joulupukki/esp32-chromatic-tuner/assembly/Schematic.png

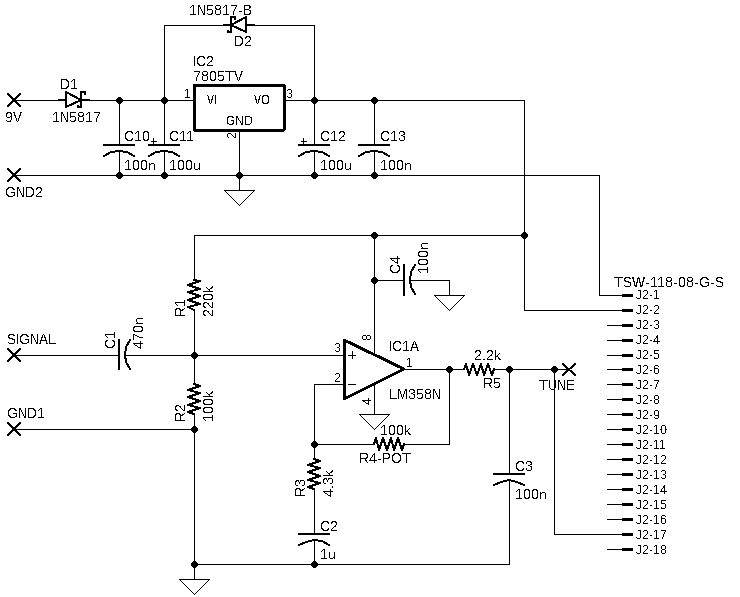
assembly/Schematic.png
