joulupukki/esp32-chromatic-tuner/assembly/Components.pdf

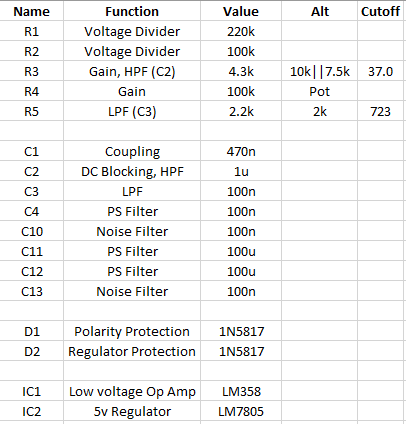
[picture p2: page 1]
