joulupukki/esp32-chromatic-tuner/(threads)

Thread 4 (2024-08-26):

Add support for a mode button/switch

joulupukki, 2024-08-26:
The tuner should be able to support multiple "modes" of tuning. This is mostly for the UI.

Two ways to implement this from a hardware perspective:
1. Use a three-way switch that's hooked up to three different GPIO pins. Depending on the switches orientation the software could (at startup) use the specified mode.
2. Use a momentary button that would cycle through the different available modes. To prevent accidental press, this could be implemented as a long press mechanism

Some modes that could be nice:
1. Normal tuning mode (what we already have)
2. Raw mode: gives just basic frequency, note, and cents reading
3. Debug mode: continuously spits out info about voltage reading, intermediate values (after applying filters etc), frequency, cents, etc.
4. Additional UI modes in the future (like simulated strobe mode or just different UI layouts)

The code needs to be changed so that it can read the value of the switch at startup and/or during each loop. Also, to keep memory consumption low, UI elements for each mode (and processing) should be torn down as needed.

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
joulupukki, 2024-12-07:
Closing this one because we're going to implement it in a different way.

Closed 2024-12-07.

Thread 11 (2024-12-07):

Add a smoothing function on the detected frequency so the UI doesn't jump around as much

joulupukki, 2024-12-07:
The ADC sampling happens at 48kHz and as soon as we detect a frequency, we're making it available to the UI. The UI updates every 100ms. The smoothing we currently have isn't sufficient and it might be nice to have an additional smoothing on the frequency output so by the time it reaches the UI, the jumps aren't as drastic or as much.

The key here is to see if we can make it so you can really tune within 0.02 cents and visually see that in the UI.

One of the things we may be up against is that the ESP32 ADC isn't the best compared with other SOCs out there. But, this is all part of the "fun" challenge of using a readily-available and inexpensive SOC.

joulupukki, 2024-12-08:
I did a little bit of work on this Saturday, Dec 7. The latest in `main` as of right now is fairly decent, though I think it can be still improved.

joulupukki, 2025-02-10:
> There’s an algorithm, not sure what it’s called, where you sample an odd number of readings, order the readings, and only use the reading in the middle of the readings. I’d like to try that on the output of the frequency readings to see if that helps smooth things a bit more.

It's called a Median Filter and I've been experimenting with it. I think it slightly improves how Q-Tune works.

Thread 9 (2024-12-07):

Try out using lv_menu instead of buttons for the settings menu

joulupukki, 2024-12-07:

joulupukki, 2024-12-07:
So far this is not going great. Even after increasing the stack size available to LVGL and using the most basic example from the LVGL documentation it still crashes regularly with an overflow error.

joulupukki, 2024-12-10:
Need to revisit this now that we have the device running at 240MHz to see if this still causes issues. Running at this faster speed has prevented the previous crashes with the note name label we were seeing.

Closed 2025-02-08.

Thread 15 (2024-12-08):

Add synchronization around the current_frequency variable (shared between both cores)

joulupukki, 2024-12-08:
The `current_frequency` global variable is the main means of communication between the two cores and it’s possible that some of the crashes that we’re experiencing could be caused by this.

Some ideas to try: https://chatgpt.com/share/67554351-7c18-8010-bc82-93a870aeeb30

Another thing to look into is the LVGL setting for sprintf. Right now, in order to make the frequency and cents measurements show up in the UI we’ve got an sdkconfig setting that doesn’t use the built-in LVGL string formatting. We may also want to look at using LVGL’s sprintf and see if *that* also reduces the number of crashes that currently happen.

joulupukki, 2024-12-08:
Maybe what needs to happen is to create a new “globals.h” file that has all of the app-wide global variables in it and also the functions that synchronize them? The other variable that needs to be there is the one that indicates that either tuning is paused or that the user settings are showing (so the pitch detection doesn’t have to run during that time). Maybe the overall “mode” of the tuner (bypass/standby/tuning/etc).

joulupukki, 2024-12-08:
Implemented 8 Dec 2024.

Closed 2024-12-08.

Thread 16 (2024-12-08):

Add support for the momentary foot switch and bypass relay control

joulupukki, 2024-12-08:
I will add more details to this later but, the app needs to read when the footswitch closes and, based on user settings, send a signal out to the latching relay to open/close. It will also need to tell the UI to pause/go into standby mode/etc.

TODO: Document what GPIO will be used for the footswitch input and the relay output.

I’m thinking that right now the footswitch reading and relay control will happen on Core 0 (where we’re doing all of the LVGL stuff) and not on Core 1 (where we’re doing ADC reading of the analog input signal).

Thread 17 (2024-12-08):

Add new menu setting inside “Tuner” that sets the bypass/standby mode

joulupukki, 2024-12-08:
Inside the Tuner/Tuning menu, we need a “Bypass Mode” or “Standby Mode” options where you can choose:

1. Mute during tuning
2. Monitor during tuning (tuning is still active)

If “Mute while tuning” is selected, we need to also figure out what to show on the screen:
1. Blank
2. Some sort of screensaver
3. Picture
4. Words? Set list? Etc.?

Thread 25 (2024-12-10):

See if it's possible to switch the main note display from text to an image

joulupukki, 2024-12-10:
For whatever reason, I'm still seeing glitches with displaying the note. It will have garbled stuff occasionally. Can an image be used instead? Can images be template images that get colorized?

joulupukki, 2024-12-10:
Still need to try image recoloring for maybe even a better experience. I still see an occasional '?' show up where the note name label should be – even for a fraction of a second.

joulupukki, 2024-12-10:
I've loaded in the [Fira Mono](https://fonts.google.com/specimen/Fira+Mono?preview.text=A%20B%20C%20D%20E%20F%20G%20%23%20%E2%80%93) font by creating PNG images of each note and then using LVGL's online image creator. Need to still do some testing.

I also bumped the memory cache size to 327680.

joulupukki, 2024-12-11:
This is now implemented with this pull request: https://github.com/joulupukki/esp32-chromatic-tuner/pull/28

Closed 2024-12-11.

Thread 31 (2024-12-11):

Touches on the CYD screen can be off – need to add a touch screen calibration option

joulupukki, 2024-12-11:
The touches on my CYD are slightly off. That means that it’s possible others will experience that too. I think that means we need to add a calibration option to the Display user settings menu.

In a quick search I discovered this project. It may have something that’d help: https://github.com/jakpaul/lvgl_touch_calibration

joulupukki, 2024-12-11:
When the software first loads, it should check to see if calibration info has been stored in Non-Volatile Storage (NVS). If it hasn’t, it should open the settings screen to calibrate it right away. Of course, give the user an option to skip it if they really want.

joulupukki, 2025-02-05:
While researching code to prevent noise I came across something (should have written it down) that this isn't actually needed with CYD. Keep an eye on it and this is something we may do in the future, but not for now.

joulupukki, 2025-02-11:
If this needs to happen in the future, this might be useful to reference: https://github.com/xperiments-in/xtouch/blob/main/src/devices/2.8/touch.h

Closed 2025-02-05.

Thread 33 (2024-12-11):

Figure out how to create a downloadable tool or method for installing firmware updates

joulupukki, 2024-12-11:
Eventually a person (non-technical) should be able to download firmware updates and install it onto the tuner without needing to install extra software like Visual Studio Code/etc. This GitHub Issue is a placeholder for doing the investigatory work and building such a tool and recommending a good release process.

joulupukki, 2025-02-08:
I did a little bit of research yesterday about this and I think what we’ll want to do is an over-the-air (OTA) update. To update the firmware you would:

1. Go into Q-Tune’s user settings
2. Go into the About menu
3. Select a Firmware Update option
4. Confirm the selection
5. The Q-Tune would reboot and would turn on Wi-Fi and broadcast a new Wi-Fi network, `q-tune-xyz` as an example with a password. Ideally, we’d figure out a way to show the network name and password on the screen.
6. You’d download the firmware update file, `q-tune-x.y.z.bin`
7. You’d then connect to the `q-tune-xyz` Wi-Fi network
8. You’d then launch a browser on your computer and go to the `q-tune.local` URL
9. You’d upload the `q-tune-x.y.z.bin` file
10. You’d click the Update button on the web page
11. Q-Tune would then install that `.bin` file and reboot into normal tuning mode with the update

joulupukki, 2025-02-10:
Turns out that the firmware for Q-Tune is too large to enable the Wi-Fi library in conjunction with it and LVGL so doing what I thought of earlier isn't going to work.

However, if we do a web-based updater, it should work. For example, just like this site: https://esphome.github.io/esp-web-tools/

joulupukki, 2025-03-25:
I have an update-installer.sh script that updates the installer but what we really need is something to support installing older versions.

Thread 48 (2025-02-05):

5kHz noise in the audio

joulupukki, 2025-02-05:
The LCD backlight code is using PWM at 5kHz and it can be heard in the audio output.

Closed 2025-02-05.

Thread 50 (2025-02-05):

Control user settings with foot switch

joulupukki, 2025-02-05:
We are planning to use a cover glass/lens to do a few different things:

1. Protect the CYD screen
2. Make a more professional looking screen in the finished product
3. Make the pedal a bit more weather/drink resistant (at least from the top)

Because of this, we will no longer be using the touch panel feature and instead need to control all of user settings from a single footswitch button.

Things that need to be done:

- [ ] Don't even initialize the touch panel (for this one we would wait and see as this may be dependent on the cover glass mounting).
- [x] Experiment with either using a long press to open user settings _or_ only going into user settings when powering on the tuner and the footswitch is depressed. Choose whichever one seems most reliable and go with it. It may be that we want to use long press later on for controlling a timer, so maybe prefer the startup hold?
- [x] Modify the menu system so there is a cursor/indicator on what is currently selected (a selection mechanism)
- [x] Use the footswitch to navigate the menu. Single press advances to the next item in the list. Double-press activates the currently-selected item. Long-press exits the menu if at the top level or going back one level in the menu hierarchy.
- [ ] Change some of the menu items to be more conducive to this new navigation. First see if it’s possible to navigate the different items (display brightness slider, tuner threshold rolling picker, advanced debugging items). If it’s not apparent right away, change those menus to use standard buttons and/or radio buttons.

Closed 2025-02-07.

Thread 52 (2025-02-07):

Before release, disable touch panel initialization

joulupukki, 2025-02-07:
We're using the foot switch to control navigation of user settings and the touch panel will no longer be used. It may be helpful in development mode, but the LCD will be covered by a cover lens.

joulupukki, 2025-03-16:
Touch is currently commented out and not being added.

joulupukki, 2025-04-21:
Closing this because we now have a new feature request to add capacitive touch with the new Waveshare ESP32 2.8" Touch.

Closed 2025-04-21.

Thread 53 (2025-02-07):

Remove the settings gear icon/button from the tuning screen before release

joulupukki, 2025-02-07:
We'll ship without the touch panel being used so there's no reason to have the settings button. Settings can be accessed with a long press of the foot switch.

joulupukki, 2025-03-25:
This is commented out now. If we restore touch capabilities we can always re-enable it.

Closed 2025-03-25.

Thread 64 (2025-03-16):

Attempt to use RMT instead of ADC Continuous reading for frequency detection

joulupukki, 2025-03-16:
It might be possible to use RMT instead of ADC measurements since the pitch detection algorithm we're using is just counting zero crossings. This is an issue to track that work.

RMT API Reference: https://docs.espressif.com/projects/esp-idf/en/v5.3.2/esp32/api-reference/peripherals/rmt.html

joulupukki, 2025-03-23:
Shelving this for now. Existing ADC is working well enough I don't think this is needed.

Closed 2025-03-23.

Thread 65 (2025-03-16):

Enhancement: Add support for the capacitive touch screen

joulupukki, 2025-03-16:
The project recently switched to use the Waveshare ESP32-S3 Touch 2.8" (240x320) and it has a capacitive touch panel. I've done some of the work at porting it over but something isn't quite right. The tuner can be controlled from the single foot switch momentary button but it might be interesting to get the touch controller fully working for easier setup menu navigation.

When I had it partially working with esp_lvgl_port it would act like it might accept a touch but would then crash.

Thread 66 (2025-03-23):

Add support for setting True Bypass & Buffered Bypass with a 2nd relay switch

joulupukki, 2025-03-23:
Use GPIO_NUM_15 for controlling a second TQ2-L2-5V relay. Add this as a user setting. When in buffered bypass mode, GPIO_NUM_15 should be set to ON which will send 3.3V. When power is cut to the pedal, it should automatically reset to the default mode (true bypass) – which isn't really a supported "feature" but it happens to work out well that way.

Thread 79 (2025-04-29):

Prep Note Quiz for release

joulupukki, 2025-04-29:
- [ ] Change the included tuner so it uses something similar to how Rocksmith’s small tuner works with a circle around the note and cents on left and right
- [ ] Show “Play now” and “Up next” on the notes
- [ ] Adapt so it functions well in landscape mode
- [ ] Revisit the colors
- [ ] See if there’s a way to give some sort of cool feedback when the target note is played. Maybe animate the new note into place?
