joulupukki/esp32-chromatic-tuner/main/defines.h

/*
 * Copyright (c) 2024 Boyd Timothy. All rights reserved.
 *
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
 * SPDX-License-Identifier: GPL-3.0-or-later
 */
#if !defined(TUNER_GLOBAL_DEFINES)
#define TUNER_GLOBAL_DEFINES

//
// Foot Switch and Relay (GPIO)
//
#define FOOT_SWITCH_GPIO                GPIO_NUM_27
#define RELAY_GPIO                      GPIO_NUM_22

#define LONG_PRESS_THRESHOLD            2000 // milliseconds
#define DOUBLE_CLICK_THRESHOLD          500 // milliseconds

//
// Default User Settings
//
#define DEFAULT_INITIAL_STATE           ((TunerState) tunerStateTuning)
#define DEFAULT_STANDBY_GUI_INDEX       (0)
#define DEFAULT_TUNER_GUI_INDEX         (0)
#define DEFAULT_IN_TUNE_CENTS_WIDTH     ((uint8_t) 2)
#define DEFAULT_NOTE_NAME_PALETTE       ((lv_palette_t) LV_PALETTE_NONE)
#define DEFAULT_DISPLAY_ORIENTATION     ((TunerOrientation) orientationNormal);
#define DEFAULT_EXP_SMOOTHING           ((float) 0.09)
#define DEFAULT_ONE_EU_BETA             ((float) 0.003)
#define DEFAULT_NOTE_DEBOUNCE_INTERVAL  ((float) 115.0)
#define DEFAULT_USE_1EU_FILTER_FIRST    (true)
// #define DEFAULT_MOVING_AVG_WINDOW       ((float) 100)
#define DEFAULT_DISPLAY_BRIGHTNESS      ((float) 0.75)

//
// Pitch Detector Related
//
#define TUNER_ADC_UNIT                    ADC_UNIT_1
#define _TUNER_ADC_UNIT_STR(unit)         #unit
#define TUNER_ADC_UNIT_STR(unit)          _TUNER_ADC_UNIT_STR(unit)
#define TUNER_ADC_CONV_MODE               ADC_CONV_SINGLE_UNIT_1
#define TUNER_ADC_ATTEN                   ADC_ATTEN_DB_12
#define TUNER_ADC_BIT_WIDTH               12

// #if CONFIG_IDF_TARGET_ESP32 || CONFIG_IDF_TARGET_ESP32S2
#define TUNER_ADC_OUTPUT_TYPE             ADC_DIGI_OUTPUT_FORMAT_TYPE1
#define TUNER_ADC_GET_CHANNEL(p_data)     ((p_data)->type1.channel)
#define TUNER_ADC_GET_DATA(p_data)        ((p_data)->type1.data)
// #else
// #define TUNER_ADC_OUTPUT_TYPE             ADC_DIGI_OUTPUT_FORMAT_TYPE2
// #define TUNER_ADC_GET_CHANNEL(p_data)     ((p_data)->type2.channel)
// #define TUNER_ADC_GET_DATA(p_data)        ((p_data)->type2.data)
// #endif

// CYD @ 48kHz
#define TUNER_ADC_FRAME_SIZE            1024
#define TUNER_ADC_BUFFER_POOL_SIZE      4096
#define TUNER_ADC_SAMPLE_RATE           (48 * 1000) // 48kHz

/// @brief This factor is used to correct the incoming frequency readings on ESP32-WROOM-32 (which CYD is). This same weird behavior does not happen on ESP32-S2 or ESP32-S3.
#define WEIRD_ESP32_WROOM_32_FREQ_FIX_FACTOR    1.2222222223 // 11/9 but using 11/9 gives completely incorrect results. Weird.

// HELTEC @ 20kHz
// #define TUNER_ADC_FRAME_SIZE            (SOC_ADC_DIGI_DATA_BYTES_PER_CONV * 256)
// #define TUNER_ADC_BUFFER_POOL_SIZE      (TUNER_ADC_FRAME_SIZE * 16)
// #define TUNER_ADC_SAMPLE_RATE           (20 * 1000) // 20kHz

// Original HELTEC
// #define TUNER_ADC_FRAME_SIZE            (SOC_ADC_DIGI_DATA_BYTES_PER_CONV * 64)
// #define TUNER_ADC_BUFFER_POOL_SIZE      (TUNER_ADC_FRAME_SIZE * 4)
// #define TUNER_ADC_SAMPLE_RATE           (5 * 1000) // 5kHz

// If the difference between the minimum and maximum input values
// is less than this value, discard the reading and do not evaluate
// the frequency. This should help cut down on the noise from the
// OLED and only attempt to read frequency information when an
// actual input signal is being read.
// #define TUNER_READING_DIFF_MINIMUM      400 // TODO: Convert this into a debug setting
#define TUNER_READING_DIFF_MINIMUM      300 // TODO: Convert this into a debug setting

//
// Smoothing
//

// 1EU Filter
#define EU_FILTER_ESTIMATED_FREQ        48000 // Same as https://github.com/bkshepherd/DaisySeedProjects/blob/main/Software/GuitarPedal/Util/frequency_detector_q.h
#define EU_FILTER_MIN_CUTOFF            0.5
#define EU_FILTER_DERIVATIVE_CUTOFF     1

//
// GUI Related
//

#define A4_FREQ                         440.0
#define CENTS_PER_SEMITONE              100

#define INDICATOR_SEGMENTS              100 // num of visual segments for showing tuning accuracy

#define GEAR_SYMBOL "\xEF\x80\x93"

//
// When the pitch stops being detected, the note can fade out. This is how long
// that animation is set to run for.
#define LAST_NOTE_FADE_INTERVAL_MS  2000

#endif
