joulupukki/esp32-chromatic-tuner/main/gpio_task.cpp

/*
 * Copyright (c) 2024 Boyd Timothy. All rights reserved.
 *
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
 * SPDX-License-Identifier: GPL-3.0-or-later
 */
#include "gpio_task.h"

#include "defines.h"
#include "globals.h"
#include "tuner_controller.h"
#include "user_settings.h"

#include "lvgl.h"
#include "esp_lvgl_port.h"
#include "esp_log.h"
#include "freertos/FreeRTOS.h"
#include "esp_timer.h"

static const char *TAG = "GPIO";

extern TunerController *tunerController;
extern UserSettings *userSettings;

// Keep track of what the relay state is so the app doesn't have to keep making
// calls to set it over and over (which chews up CPU).
uint32_t current_relay_gpio_level = 0; // Off at launch

int footswitch_last_state = 1; // Assume initial state is open (active-high logic and conveniently matches the physical position of the footswitch)
int footswitch_press_count = 0;
int64_t footswitch_start_time = 0;
int64_t footswitch_last_press_time = 0;
bool footswitch_long_press_triggered = false;

//
// Local Function Declarations
//
void configure_gpio_pins();
void handle_gpio_pins();
void ensure_relay_state();
void handle_normal_press();
void handle_double_press();
void handle_long_press();

void gpio_task(void *pvParameter) {
    ESP_LOGI(TAG, "GPIO task started");
    configure_gpio_pins();

    while(1) {
        handle_gpio_pins();
        ensure_relay_state();

        vTaskDelay(pdMS_TO_TICKS(50)); // Small delay for debouncing
    }
    vTaskDelay(portMAX_DELAY);
}

void configure_gpio_pins() {
    // Configure GPIO 27 as an input pin
    gpio_config_t gpio_27_conf = {
        .pin_bit_mask = (1ULL << FOOT_SWITCH_GPIO),
        .mode = GPIO_MODE_INPUT,
        .pull_up_en = GPIO_PULLUP_ENABLE,   // Enable internal pull-up resistor
        .pull_down_en = GPIO_PULLDOWN_DISABLE,
        .intr_type = GPIO_INTR_DISABLE      // Disable interrupt for this pin
    };

    gpio_config(&gpio_27_conf);

    // Configure GPIO 22 as an output pin
    gpio_config_t gpio_22_conf = {
        .pin_bit_mask = (1ULL << RELAY_GPIO),
        .mode = GPIO_MODE_OUTPUT,
        .pull_up_en = GPIO_PULLUP_DISABLE,
        .pull_down_en = GPIO_PULLDOWN_DISABLE,
        .intr_type = GPIO_INTR_DISABLE
    };

    gpio_config(&gpio_22_conf);

    // TODO: Read the initial state of the foot switch. If it's a 0, that means
    // the user had it pressed at power up and we may want to do something
    // special.

    // Make sure the relay start out as off
    gpio_set_level(RELAY_GPIO, 0); // Turn off GPIO 22
    current_relay_gpio_level = 0;
}

void handle_gpio_pins() {

    // Detect press, double-press, and long press.

    int current_footswitch_state = gpio_get_level(FOOT_SWITCH_GPIO);

    if (current_footswitch_state == 0 && footswitch_last_state == 1) {
        // Button pressed
        footswitch_start_time = esp_timer_get_time() / 1000; // Get time in ms
        int64_t now = footswitch_start_time;

        if ((now - footswitch_last_press_time) <= DOUBLE_CLICK_THRESHOLD) {
            footswitch_press_count++;
        } else {
            footswitch_press_count = 1;
        }

        footswitch_last_press_time = now;
        footswitch_long_press_triggered = false; // Reset long press trigger when pressed
    }

    if (current_footswitch_state == 0) {
        // Button is being held down
        int64_t press_duration = (esp_timer_get_time() / 1000) - footswitch_start_time;

        if (press_duration >= LONG_PRESS_THRESHOLD && !footswitch_long_press_triggered) {
            handle_long_press();
            footswitch_long_press_triggered = true; // Ensure long press is only triggered once
            vTaskDelay(pdMS_TO_TICKS(200)); // Small delay for visual feedback
        }
    }

    if (current_footswitch_state == 1 && footswitch_last_state == 0) {
        // Button released
        if (!footswitch_long_press_triggered) {
            int64_t press_duration = (esp_timer_get_time() / 1000) - footswitch_start_time;

            if (footswitch_press_count == 2) {
                handle_double_press();
                vTaskDelay(pdMS_TO_TICKS(200)); // Small delay for visual feedback
            } else if (press_duration < LONG_PRESS_THRESHOLD) {
                handle_normal_press();
                vTaskDelay(pdMS_TO_TICKS(200)); // Small delay for visual feedback
            }
        }
    }

    footswitch_last_state = current_footswitch_state;

    // gpio_set_level(RELAY_GPIO, 1); // Turn on GPIO 22
    // current_relay_gpio_level = 1;

    // gpio_set_level(RELAY_GPIO, 0); // Turn off GPIO 22
    // current_relay_gpio_level = 0;
}

/// The purpose of this function is to make sure the relay is in the correct
/// state according to the tuner's current state. This is really only needed
/// for initial startup. We want to keep the controlling of the relay all done
/// here in gpio_task but if the user has tuning set as their initial startup
/// screen, we need to make sure to turn the relay on.
void ensure_relay_state() {
    TunerState current_state = tunerController->getState();
    if (current_state == tunerStateStandby && current_relay_gpio_level != 0) {
        gpio_set_level(RELAY_GPIO, 0); // Turn off GPIO 22
        current_relay_gpio_level = 0;
    } else if (current_state == tunerStateTuning && current_relay_gpio_level != 1) {
        gpio_set_level(RELAY_GPIO, 1); // Turn on GPIO 22
        current_relay_gpio_level = 1;
    }
}

void handle_normal_press() {
    ESP_LOGI(TAG, "NORMAL PRESS detected");

    TunerState state = tunerController->getState();
    switch (state) {
    case tunerStateStandby:
        ESP_LOGI(TAG, "Turning ON the relay and going to tuning mode");
        // Turn on the relay which should mute the output
        gpio_set_level(RELAY_GPIO, 1); // Turn on GPIO 22
        current_relay_gpio_level = 1;
        
        // Go to tuning mode
        tunerController->setState(tunerStateTuning);
        break;
    case tunerStateTuning:
        ESP_LOGI(TAG, "Turning OFF the relay and going to standby mode");
        // Turn off the relay which should unmute the output
        gpio_set_level(RELAY_GPIO, 0); // Turn off GPIO 22
        current_relay_gpio_level = 0;

        // Go to standby mode
        tunerController->setState(tunerStateStandby);
        break;
    default:
        break;
    }
}

void handle_double_press() {
    ESP_LOGI(TAG, "DOUBLE PRESS detected");

    // If we decide to use this for something, we have to make it so that it
    // reverses whatever the single press does. Take a look at Ditto+ and its
    // double tap behavior and you'll see the same behavior.
}

void handle_long_press() {
    ESP_LOGI(TAG, "LONG PRESS detected");

    // What cool thing are we going to use this for? Maybe cycle through the
    // different tuning modes?
}
