joulupukki/esp32-chromatic-tuner/main/utils/exponential_smoother.hpp

#if !defined(TUNER_EXPONENTIAL_SMOOTHER)
#define TUNER_EXPONENTIAL_SMOOTHER

#include <vector>
#include <algorithm>

class ExponentialSmoother {
public:
    ExponentialSmoother(float amount) : amount(amount) {
        amount = std::min(amount, 1.0f);
        amount = std::max(amount, 0.0f);
    }

    float smooth(float value) {
        float newValue = value;
        if (values.size() > 0) {
            float last = values.back();
            newValue = (amount * value) + (1.0 - amount) * last;
            if (values.size() > 2) {
                values.erase(values.begin()); // remove the first item
            }
        }
        values.push_back(value);
        return newValue;
    }

    void setAmount(float newAmount) {
        amount = std::min(amount, 1.0f);
        amount = std::max(amount, 0.0f);
    }

    void reset() {
        (void)values.empty();
    }

private:
    std::vector<float> values;
    float amount;
};

#endif
